rniwase/3340vco-4hp/README.md

# 3340VCO
An 4HP Eurorack VCO module using Coolaudio V3340 (CEM3340 second-source).

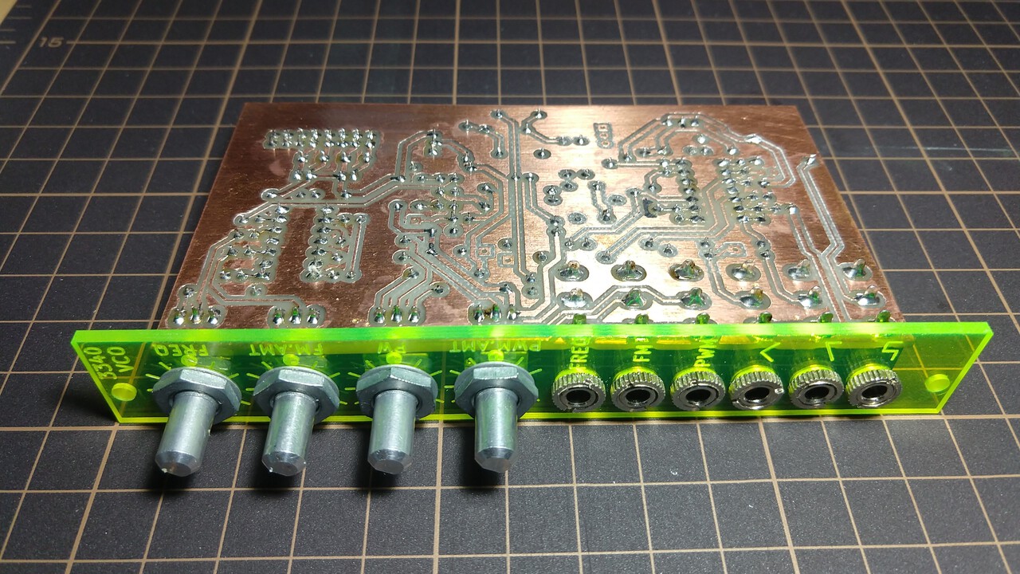
[picture p1: misc/photo0.jpg]

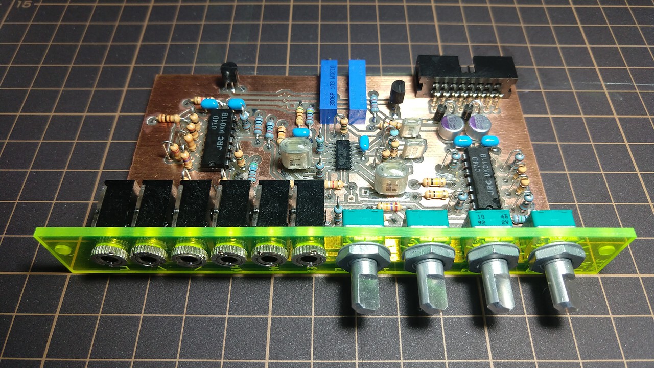
[picture p2: misc/photo1.jpg]
