rniwase/3340vco-4hp/pcb_main/3340VCO_pcb_main.kicad_pcb

## KiCad design pcb_main/3340VCO_pcb_main.kicad_pcb (2022-08-26)

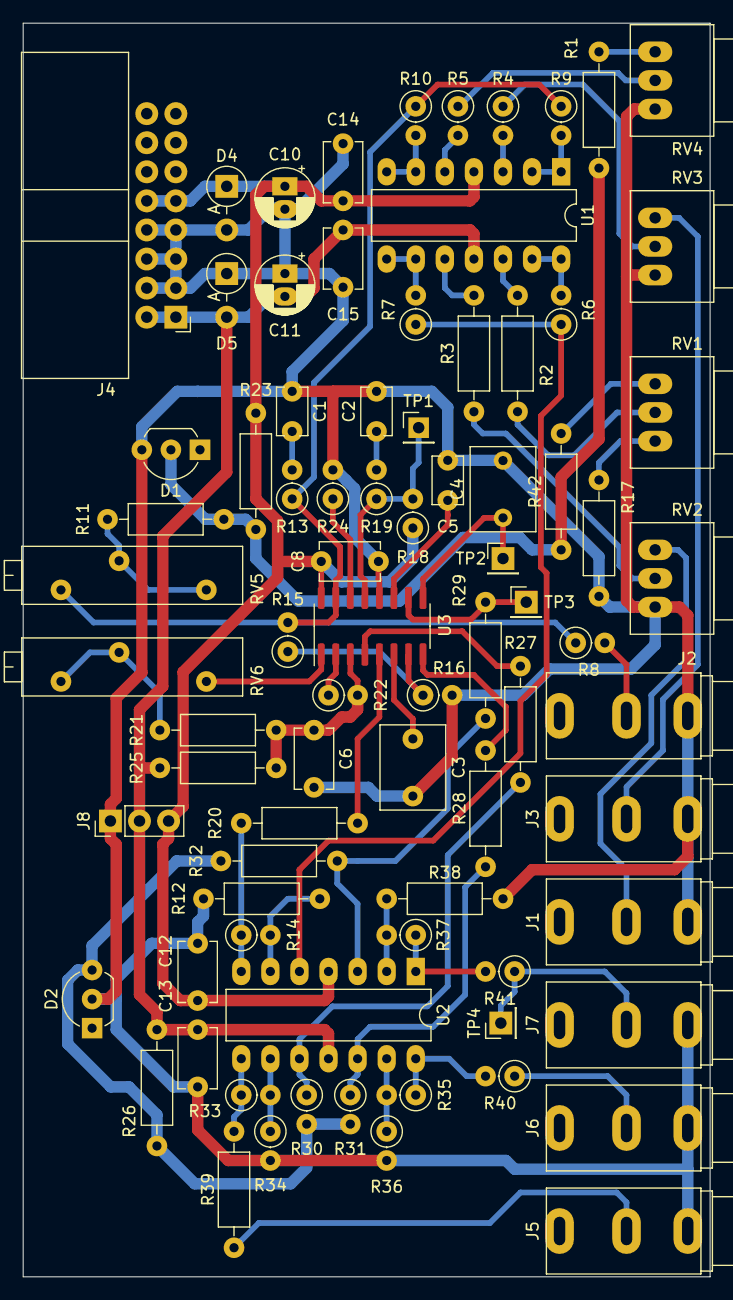
[picture p3: board 3340VCO_pcb_main.kicad_pcb from above]

Board: 2 copper layers, 60.0 x 109.5 mm, 80 parts (0 on the bottom side), 56 nets.

Parts:
C1, C2: 10n; C_Rect_L4.0mm_W2.5mm_P2.50mm
C3, C4: 0.1μ; C_Rect_L7.2mm_W5.5mm_P5.00mm_FKS2_FKP2_MKS2_MKP2
C5: 1n; C_Rect_L4.0mm_W2.5mm_P2.50mm
C6, C8: 2.2μ; C_Disc_D5.1mm_W3.2mm_P5.00mm
C10, C11: 22μ; CP_Radial_D5.0mm_P2.00mm
C12, C13, C14, C15: 10μ; C_Disc_D5.1mm_W3.2mm_P5.00mm
D1, D2: LM336Z-5.0; TO-92_Inline_Wide
D4, D5: 1N4007; D_DO-41_SOD81_P3.81mm_Vertical_AnodeUp
J1, J2, J3, J5, J6, J7: MJ-352
J4: POWER_IN; IDC-Header_2x08_P2.54mm_Horizontal
J8: EXT_POW; PinHeader_1x03_P2.54mm_Vertical
R1: 150k; R_Axial_DIN0207_L6.3mm_D2.5mm_P10.16mm_Horizontal
R2, R3, R12: 100k; R_Axial_DIN0207_L6.3mm_D2.5mm_P10.16mm_Horizontal
R4, R5, R6, R7, R8, R9, R10, R14: 100k; R_Axial_DIN0207_L6.3mm_D2.5mm_P2.54mm_Vertical
R11: 82k; R_Axial_DIN0207_L6.3mm_D2.5mm_P10.16mm_Horizontal
R13: 470; R_Axial_DIN0207_L6.3mm_D2.5mm_P2.54mm_Vertical
R15, R18: 1.5M; R_Axial_DIN0207_L6.3mm_D2.5mm_P2.54mm_Vertical
R16: 10k; R_Axial_DIN0207_L6.3mm_D2.5mm_P2.54mm_Vertical
R17: 1.5k; R_Axial_DIN0207_L6.3mm_D2.5mm_P10.16mm_Horizontal
R19: 560; R_Axial_DIN0207_L6.3mm_D2.5mm_P2.54mm_Vertical
R20, R32: 10k; R_Axial_DIN0207_L6.3mm_D2.5mm_P10.16mm_Horizontal
R21: 24k; R_Axial_DIN0207_L6.3mm_D2.5mm_P10.16mm_Horizontal
R22: 5.6k; R_Axial_DIN0207_L6.3mm_D2.5mm_P2.54mm_Vertical
R23, R26: 1k; R_Axial_DIN0207_L6.3mm_D2.5mm_P10.16mm_Horizontal
R24: 1.8k; R_Axial_DIN0207_L6.3mm_D2.5mm_P2.54mm_Vertical
R25: 510; R_Axial_DIN0207_L6.3mm_D2.5mm_P10.16mm_Horizontal
R27: 12k; R_Axial_DIN0207_L6.3mm_D2.5mm_P10.16mm_Horizontal
R28, R42: 27k; R_Axial_DIN0207_L6.3mm_D2.5mm_P10.16mm_Horizontal
R29: 3.9k; R_Axial_DIN0207_L6.3mm_D2.5mm_P10.16mm_Horizontal
R30: 20k; R_Axial_DIN0207_L6.3mm_D2.5mm_P2.54mm_Vertical
R31: 33k; R_Axial_DIN0207_L6.3mm_D2.5mm_P2.54mm_Vertical
R33: 0; R_Axial_DIN0207_L6.3mm_D2.5mm_P2.54mm_Vertical
R34: DNP; R_Axial_DIN0207_L6.3mm_D2.5mm_P2.54mm_Vertical
R35: 27k; R_Axial_DIN0207_L6.3mm_D2.5mm_P2.54mm_Vertical
R36: 22k; R_Axial_DIN0207_L6.3mm_D2.5mm_P2.54mm_Vertical
R37: 15k; R_Axial_DIN0207_L6.3mm_D2.5mm_P2.54mm_Vertical
R38: 5.6k; R_Axial_DIN0207_L6.3mm_D2.5mm_P10.16mm_Horizontal
R39: 100; R_Axial_DIN0207_L6.3mm_D2.5mm_P10.16mm_Horizontal
R40, R41: 100; R_Axial_DIN0207_L6.3mm_D2.5mm_P2.54mm_Vertical
RV1, RV2, RV3, RV4: 100k; Potentiometer_Alps_RK097_Single_Horizontal
RV5: 50k; Potentiometer_Bourns_3006P_Horizontal
RV6: 10k; Potentiometer_Bourns_3006P_Horizontal
TP1: VLFI; PinHeader_1x01_P2.54mm_Vertical
TP2: VSSI; PinHeader_1x01_P2.54mm_Vertical
TP3: VTO; PinHeader_1x01_P2.54mm_Vertical
TP4: TRIOUT; PinHeader_1x01_P2.54mm_Vertical
U1, U2: NJM074; DIP-14_W7.62mm_LongPads
U3: V3340M; SOIC-16_3.9x9.9mm_P1.27mm

Connections:
+5V: D1.2 (K), R1.1, R11.2, R23.2, R42.1
+12V: C8.2, C10.1, C12.1, C14.1, D4.1 (K), J4.9, J4.10, J8.3, R18.1, R23.1, U1.4 (V+), U2.4 (V+), U3.16 (VCC)
-5V: D2.3 (A), R26.1, R30.2, R31.2, R32.2
-12V: C11.2, C13.1, C15.1, D5.2 (A), J4.1, J4.2, J8.2, R25.2, R26.2, U1.11 (V-), U2.11 (V-)
GND: C1.2, C2.2, C3.2, C4.2, C5.2, C6.2, C8.1, C10.2, C11.1, C12.2, C13.2, C14.2, C15.2, D1.3 (A), D2.2 (K), D4.2 (A), D5.1 (K), J1.S, J2.S, J3.S, J4.3, J4.4, J4.5, J4.6, J4.7, J4.8, J5.S, J6.S, J7.S, J8.1, R12.2, R16.2, R17.2, R24.2, R34.2, R36.2, R38.2, RV2.1, RV3.1, RV4.1, U3.12 (GND)
unnamed: C1.1, R13.2
unnamed: C2.1, R19.2
unnamed: C3.1, U3.6 (VHSI)
unnamed: C4.1, TP2.1, U3.9 (VSSI)
unnamed: C5.1, U3.11 (CAP)
unnamed: J1.T, RV2.3
unnamed: J2.T, R8.2
unnamed: J3.T, RV3.3
unnamed: J5.T, R39.1
unnamed: J6.T, R40.1
unnamed: J7.T, R41.1, TP4.1
unnamed: R1.2, RV4.3
unnamed: R2.1, U1.12 (+)
unnamed: R2.2, RV1.2
unnamed: R3.1, U1.10 (+)
unnamed: R3.2, RV2.2
unnamed: R4.1, RV3.2
unnamed: R4.2, U1.3 (+)
unnamed: R5.1, RV4.2
unnamed: R5.2, U1.5 (+)
unnamed: R6.1, R7.1, U2.5 (+)
unnamed: R6.2, U1.13 (-), U1.14
unnamed: R7.2, U1.8, U1.9 (-)
unnamed: R9.2, U1.1, U1.2 (-)
unnamed: R8.1, R9.1, R10.1, R13.1, R15.2, RV5.3, U3.15 (VFCI)
unnamed: R10.2, U1.6 (-), U1.7
unnamed: R11.1, RV5.1, RV5.2
unnamed: R12.1, R14.2, U2.6 (-)
unnamed: R14.1, R20.2, U2.7
unnamed: R15.1, R16.1, U3.7 (VHFT)
unnamed: R17.1, RV1.1
unnamed: R18.2, R19.1, TP1.1, U3.13 (VLFI)
unnamed: R20.1, U3.5 (VPWM)
unnamed: R21.1, RV6.2, RV6.3
unnamed: R22.1, U3.2 (SCALE2)
unnamed: R24.1, U3.14 (VS)
unnamed: R27.1, R30.1, U2.10 (+)
unnamed: R27.2, U3.4 (VP)
unnamed: R28.1, R31.1, U2.12 (+)
unnamed: R28.2, U3.8 (VSO)
unnamed: R29.1, R32.1, U2.3 (+)
unnamed: R29.2, TP3.1, U3.10 (VTO)
unnamed: R33.1, R39.2, U2.8
unnamed: R33.2, R34.1, U2.9 (-)
unnamed: R35.1, R40.2, U2.14
unnamed: R35.2, R36.1, U2.13 (-)
unnamed: R37.1, R41.2, U2.1
unnamed: R37.2, R38.1, U2.2 (-)
unnamed: R42.2, RV1.3
unnamed: RV6.1, U3.1 (SCALE1)
VEE: C6.1, R21.2, R22.2, R25.1, U3.3 (VEE)
