rniwase/3340vco-4hp/(commit log)

2020-05-11 pcb_main modify height: 114.5->109.5mm, optimize pad/drill diameter
    [3340VCO_pcb_main.kicad_pcb]
2020-05-11 adjust vertical hole position
    [3340VCO_frontpanel.kicad_pcb]
2020-05-12 flip RV5 pin assign, add power source protection diode
    [3340VCO_pcb_main.kicad_pcb, 3340VCO_pcb_main.sch]
2020-05-13 update schematic
    [3340VCO_pcb_main.sch]
2020-05-14 redesign pcb_main for double-side
    [3340VCO_pcb_main.kicad_pcb, 3340VCO_pcb_main.sch]
2020-05-14 update draft cad data
2020-05-14 tweak pcb_main, adjust frontpanel horizontal position
    [3340VCO_frontpanel.kicad_pcb, 3340VCO_pcb_main.kicad_pcb]
2020-05-15 output gerber
    [3340VCO_frontpanel-Edge_Cuts.gbr, 3340VCO_frontpanel-F_SilkS.gbr, 3340VCO_frontpanel-NPTH.drl, 3340VCO_frontpanel-PTH.drl, 3340VCO_pcb_main-B_Cu.gbr, 3340VCO_pcb_main-Edge_Cuts.gbr, 3340VCO_pcb_main-F_Cu.gbr, 3340VCO_pcb_main-NPTH.drl]
2020-05-22 place F.Silk
    [3340VCO_pcb_main.kicad_pcb]
2020-08-15 replace reference Diode: 1N5231B to LM336Z-5.0, update schematic and pcb
    [3340VCO_pcb_main.kicad_pcb, 3340VCO_pcb_main.sch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]
2020-08-16 regenerate gerber, g-code
    [3340VCO_pcb_main-B_Cu.gbr, 3340VCO_pcb_main-Edge_Cuts.gbr, 3340VCO_pcb_main-F_Cu.gbr, 3340VCO_pcb_main-NPTH.drl, 3340VCO_pcb_main-PTH.drl, v3340_eurorack-B_Cu.gbr, v3340_eurorack-Edge_Cuts.gbr, v3340_eurorack-PTH-oval.drl]
2022-08-26 migrate to KiCAD 6.0
    [3340VCO_frontpanel.kicad_pcb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]
